vybhavraghav/steadystrideV1.0/steady_stride_v0/Circuits/2] Robot Arduino Mega IO-Communications Circuit.pdf

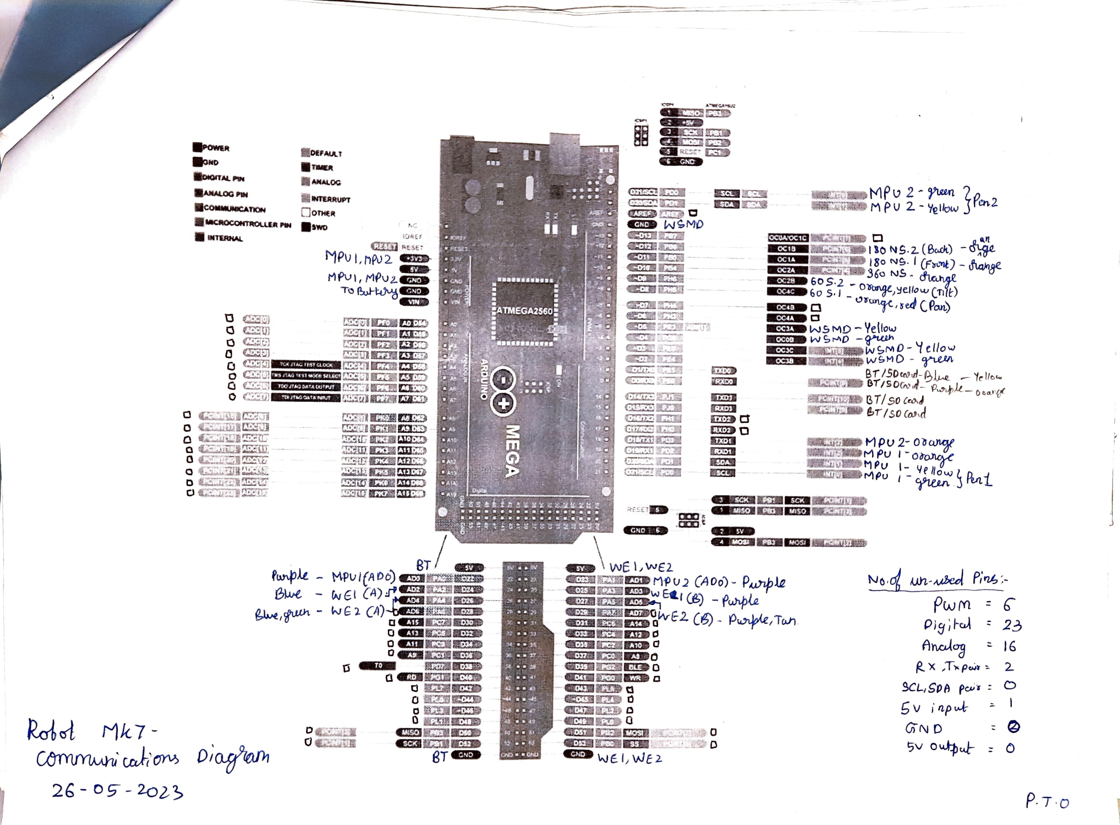
[picture p38: page 1]

PoWER
GND
DIGTA PN

26- 05 -2023

ANAL0G PN
coMMUANCATION

INTERNAL

## Roto Mk7

## Commari cahons Dragan

DEFAULT
TOER
ANALoG
MCROcONTROLLER PN SwO NTERRUPT CorHER

RE RESE
MP,Dp2
MAU,MPU2GsO To botty

TO HA DATA COTPt CAD

D

TK A

Panple - MPuI{ADO)

GNO

BT

elue,ch wE2 CA)bA2

OA1

O | D

SCKPD32
RT CND

# OO iNO MEGA

FATMEGA2560

C

GAD MO

RESESN:

GNOS

WEI,WE2

SDA

XDO

CAD WEI, WE 2

RD

Ro

SCUt

Do

OC1B
OC1A
OcA

OCAC

CCIA
OCOa
OC3C
3 SCK | P91 | SCK
oZ0 MPU2 CADo)- Parle G025ASA3WELI (e) -Purpe SD | A0TOW E2 (6)- Pre, Th.

oC38N

MaSP89NOSI

KS|30 NG.2. (Bac) -ge 180 NS. I (Fynt) - Gange 3Ko NS.
60S.2
60 S.J

MPU 2 green D MPV 2. - Yo llow

-Yellow
BT/5D ad-lue
RT/So Ceod
BTIso (ard

C,sed CPan)
wSMO~ Yellow

EMPU 2- 00n

## NESMPUIOtone

een

No- unbed Pinsi
Pwm
Pigitol

### Ancog

Ye llo

Rx T peis
5v input
5u outut

6
23
J6
2

### P.T-O

# MPUE MPU 605o 9ros ape Modde: MPUl, MPO2

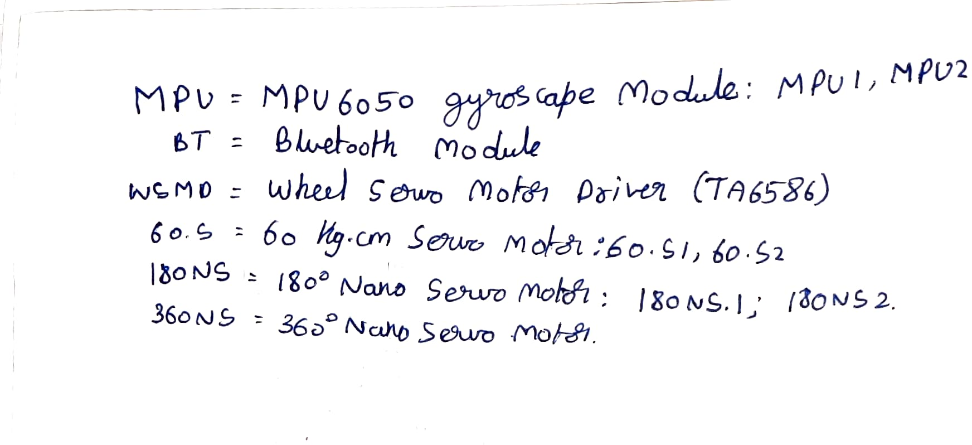
[picture p39: page 2]

# 6T Buetooth Modue =

# weMO : whel seu Moto poier (TA6586)

# 6o.9 6o hg-cm Sou Motii6o. Sl, 6o.52 |80 NS

360 NS

180° Nano Sero Motoi : |80 NS.I; 36° N | (00NS2. Seso Mofi.
