vybhavraghav/steadystrideV1.0/CAD/wheel_shaft_manas.stl

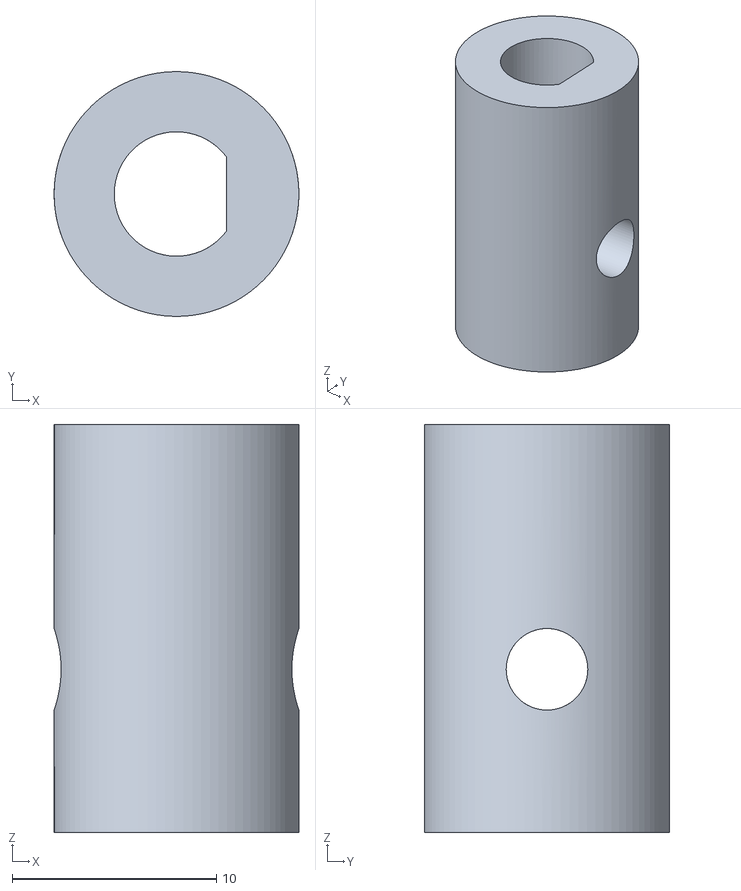
[picture p45: CAD file, 2024-04-16]
CAD/wheel_shaft_manas.stl
12.0 x 12.0 x 20.0
