vybhavraghav/steadystrideV1.0/steady_stride_v0/Codes/src/libraries_dependencies/MPU6050/examples/MPU6050_DMP6_using_DMP_V6v12/MPUplane/data/biplane.obj

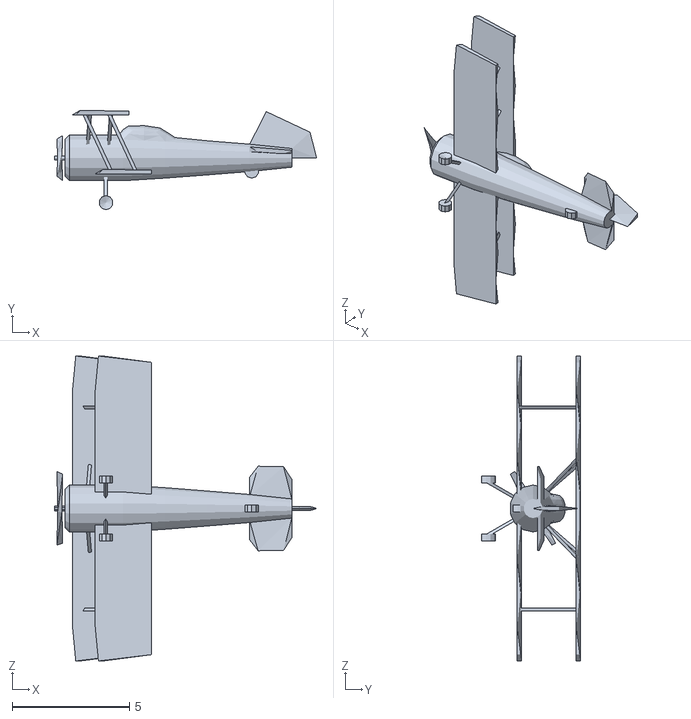
[picture p46: CAD file, 2024-02-13]
steady_stride_v0/Codes/src/libraries_dependencies/MPU6050/examples/MPU6050_DMP6_using_DMP_V6v12/MPUplane/data/biplane.obj
11.2 x 4.23 x 13.0
