vybhavraghav/steadystrideV1.0/CAD/Motor_shaft.stl

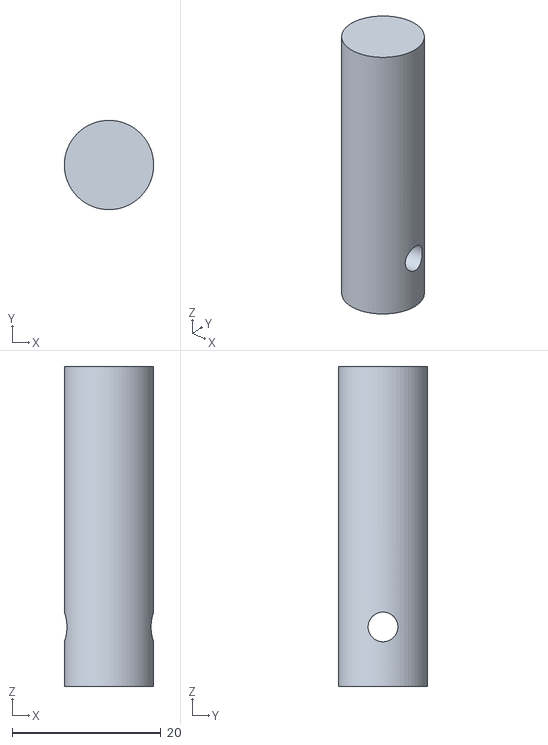
[picture p47: CAD file, 2024-04-16]
CAD/Motor_shaft.stl
12.0 x 12.0 x 43.0
