vybhavraghav/steadystrideV1.0/(commit log)

2024-02-13 old files
    [biplane.obj]
2024-04-19 data logging
    [TEST1.csv, TEST2.csv]
