vybhavraghav/steadystrideV1.0/(notices)

Notices in the files:
steady_stride_v0/Codes/src/libraries_dependencies/Servo_Easing_SoftMotion-main/pinDef.h:
IRMP is free software: you can redistribute it and/or modify
it under the terms of the GNU General Public License as published by
the Free Software Foundation, either version 3 of the License, or
(at your option) any later version.
along with this program. If not, see <http://www.gnu.org/licenses/gpl.html>.
